phorton1/Arduino-TE3_audio/docs/kicad/looper3/looper3.kicad_pcb

## KiCad design docs/kicad/looper3/looper3.kicad_pcb (2025-02-02)

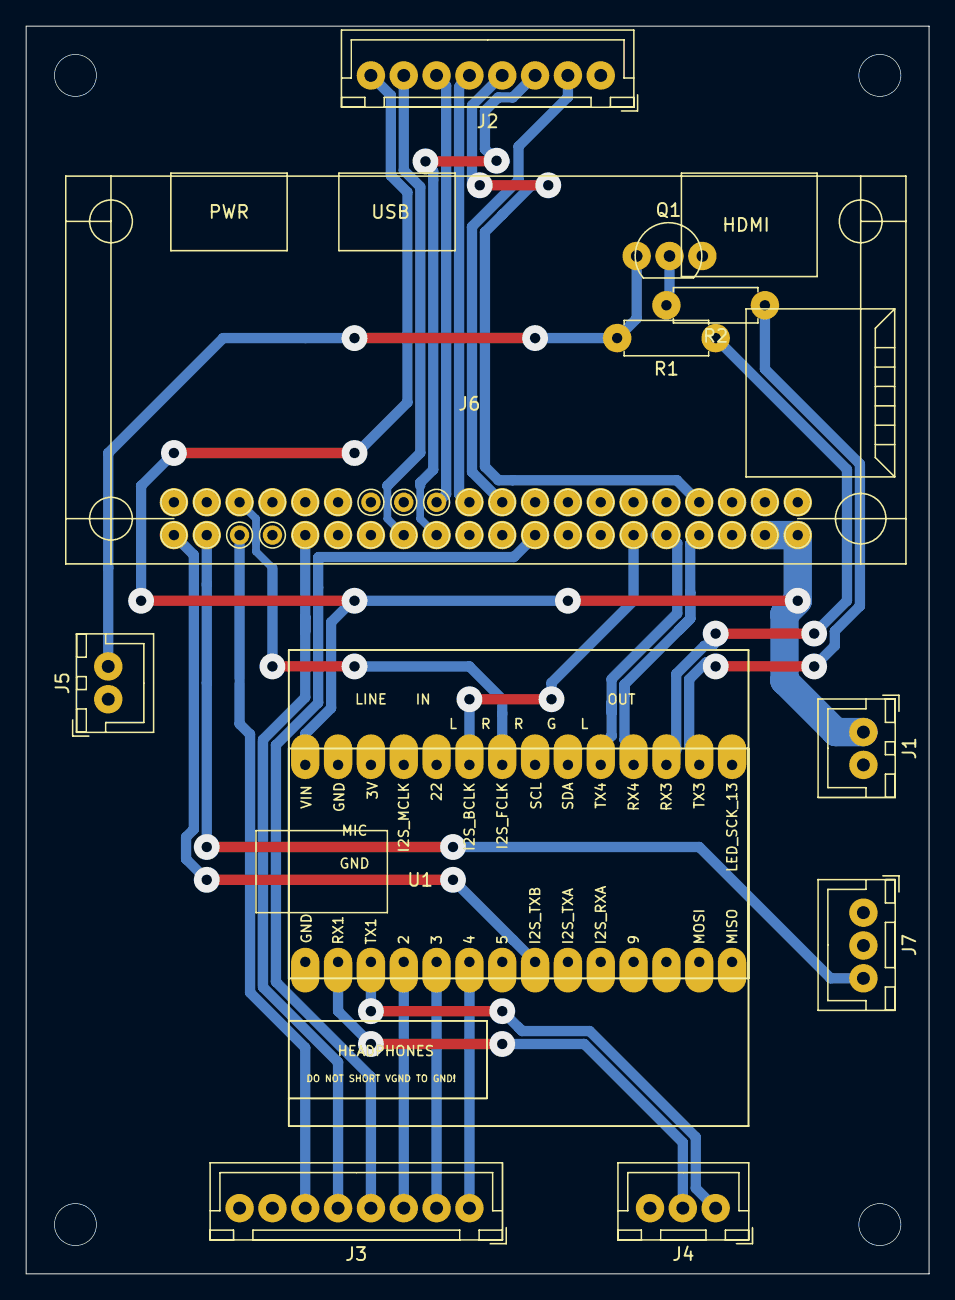
[picture p1: board looper3.kicad_pcb from above]

Board: 2 copper layers, 69.8 x 96.5 mm, 11 parts (0 on the bottom side), 26 nets.

Parts:
J1: rPi_5V; myJSTx02
J2: RPI_DISPLAY; myJSTx08
J3: EXT_LEDS; myJSTx08
J4: TE3 SERIAL; myJSTx03
J5: RPI_RUN; myJSTx02
J6: rpi_connector; rpi_zero_2w
J7: I2S_TXB; myJSTx03
Q1: BC547; myTransistor
R1: 220; myResistor
R2: 1K; myResistor
U1: teensyAudioRevD; revDTeensy4Stack

Connections:
+5V: J1.1, J2.8, J6.2, J6.4, U1.28
GND: J1.2, J2.1, J3.7, J4.3, J5.1, J6.6, J6.9, J6.14, J6.20, J6.25, J6.30, J6.34, J6.39, Q1.3, U1.1, U1.27
I2S_BCLK: J6.12, U1.23
I2S_FCLK: J6.35, U1.22
I2S_RXB: J6.40, U1.8
I2S_TXB: J6.38, J7.3
LED_AUDIO_BUSY: J3.3, U1.4
LED_RPI_BUSY: J3.4, J6.18
LED_RPI_I2S_RX: J3.5, J6.32
LED_RPI_I2S_TX: J3.6, J6.36
LED_RPI_READY: J3.2, U1.5
LED_RPI_RUN: J3.1, U1.6
unnamed: Q1.2, R2.2
PI_REBOOT: R2.1, U1.16
RPI_LCD_CS: J2.3, J6.24
RPI_LCD_DC: J2.4, J6.7
RPI_MISO: J2.5, J6.21
RPI_MOSI: J2.2, J6.19
RPI_RUN: J5.2, Q1.1, R1.2
RPI_SCLK: J2.6, J6.23
RPI_T_CS: J2.7, J6.26
SENS_PI_RUN: R1.1, U1.17
T40_RX1: J4.2, U1.2
T40_RX4: J6.8, U1.18
T40_TX1: J4.1, U1.3
T40_TX4: J6.10, U1.19
