phorton1/Arduino-TE3_audio/(commit log)

2024-05-11 added .gitignore to all TE related doc/kicad folders. Renamed and moved kicad designs around. See /junk/maybe_save for remnants
    [audio_board.kicad_pcb, audio_board.sch]
2024-05-12 updated kicad .gitignore's
2024-05-13 update all TE preferences.txt to build in /src/ArduinoBuilds for easier clean builds
2024-05-13 added audio_breadboard, touched the audio_board design
    [audio_board.kicad_pcb, audio_board.sch, audio_breadboard.sch, board_with_rpi_dimensions.kicad_pcb]
2024-05-13 started TE3_hub - tested midiHost and hookup to ESP32 TE3
2024-05-14 reworked API and renamed to mySGTL5000
    [TE3_hub.ino, sgtl5000.h]
2024-05-15 added Arduino-libraries-TE3_common repo, starting with (renamed) teSGTL5000.h and cpp
2024-05-18 HOST mode generates a lot of noise. USB device names working with limitations, FTP Spoof worked and revealed that HOST mode generates a lot of noise.
    [TE3_hub.ino, _usb.c, _usbNames.c, _usb_desc.c]
2024-05-20 completely reworked TE3_hub audio_system usage, #defines, and routing
    [TE3_hub.ino]
2024-05-21 After first tests with iPad USB - reworked TE3_hub audio setup; reworked SGTL5000 setDefaults() and some method semantics; moved sgtl5000 implementation to TE3_hub; made sgtl5000midi.h and teCommon.h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
    [TE3_hub.ino, sgtl5000.cpp, sgtl5000.h]
2024-05-22 ABANDONING TE3_hub - unfortunately, during testing several factors rule this approach out - the SGTL5000 I2S<->audio works ok and may still be in future designs, but ... - there were noticable and re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
    [TE3_hub.ino, sgtl5000.cpp]
2024-05-29 added (yet another) teensyExpression2 _prototype1 kicad design for esp32-rpi-sgtl5000 testing
2024-05-31 rework/cleanup TE3_HUB - added a sine wave generator for USB glitch/hiccup testing
    [TE3_hub.ino]
2025-01-22 restart TE3 project - BEFORE CHANGING TE3 TO TEENSY 4.1 - LAST ESP32 TE3 version
    [audio_breadboard.sch]
2025-01-23 got rid of (many) vestigial TE3 design attempts; consolidating electronics under TE3/docs/kicad
    [audio_board.kicad_pcb, audio_board.sch, board_with_rpi_dimensions.kicad_pcb]
2025-01-24 added comments regardin I2S pin usage on teensies, audio shield(s), and rPi
2025-01-24 renamed TE3_hub to TE3_audio
    [audio_breadboard.sch]
2025-01-24 fixed erroneous comment re teensy4 I2S_RXB pin
    [TE3_audio.ino]
2025-01-31 update teensy Arduino preferences.txt to work on USBC hub
2025-02-02 add BUSY (as well as current ALIVE) LEDa
2025-02-02 continuing work on TE3 kicad designs
    [looper3.kicad_pcb, looper3.sch]
2025-02-06 changed PIN_LED_AUDIO_BUSY to prevent conflict with CS pin
    [TE3_audio.ino]
2025-02-06 FINALLY landed on the store bought USBC hub solution. It works in any cable orientation and charges the iPad at 15V/25W while also working with USB midi, and presumably audio, data. - remove glue and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
2025-02-07 mod TE3 pins accoring to mother_board design (reworked breadboard)
    [TE3_audio.ino]
2025-03-06 final integration test before adding audio connectors, hot gluing wires, and cutting wood base - tested with usbC hub, deleted all COM and TE3 related devices so TE3 is now COM3 and TE3_audio is COM4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
2025-03-10 added DEBUG_AUDIO_LEVELS, MONO_GUITAR_INPUT, and TEST_RPI_WITHOUT_IPAD defines - DEBUG_AUDIO_LEVELS introduces 8 AudioAnalyzePeak devices that output every 250ms or so, various levels to help me debu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
    [TE3_audio.ino]
2025-03-11 check in TE3, TE3_audo, circle/_prh, and _apps/Looper after initial TE3 integration success. - rotaries don't work - only very few USBC cables work on the iPad, but strangely those that do, also work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
